njreed53/Power-Factor-Correction-System/images/FunctionalDecomposition.png

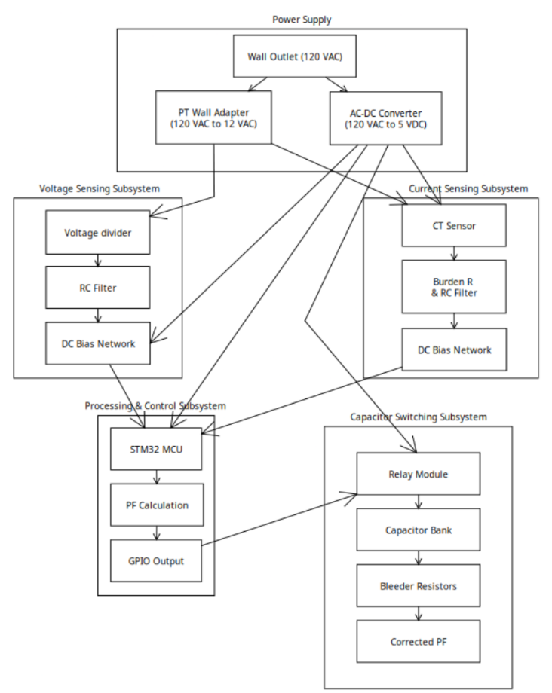
images/FunctionalDecomposition.png
