njreed53/Power-Factor-Correction-System/firmware/Core/Src/main.c

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
/* Includes ------------------------------------------------------------------*/
#include "main.h"

/* USER CODE BEGIN Includes */
#include "I2C_LCD_PCF8574.h"
#include <stdio.h>
#include <stdlib.h>
#include <string.h>
#include <math.h>
/* USER CODE END Includes */

/* USER CODE BEGIN PD */
#define SAMPLE_COUNT 500
#define SENSOR_GAIN     1			// NEED TO ADD GAIN FOR VOLTAGE
#define PF_TARGET       0.95f
#define PF_HYST         0.02f
#define PF_FILTER_SIZE  10
#define Q_MIN           2.0f
#define MIN_V           0.05f
#define MIN_I           0.01f
/* USER CODE END PD */

ADC_HandleTypeDef hadc1;
DMA_HandleTypeDef hdma_adc1;

I2C_HandleTypeDef hi2c1;

TIM_HandleTypeDef htim2;

UART_HandleTypeDef huart2;

/* USER CODE BEGIN PV */
volatile uint32_t adc_dma_buffer[2 * SAMPLE_COUNT];
volatile uint8_t buffer_full = 0;
static uint8_t relay_state = 0;
char msg[50];
char lcd_string[17];
float pf = 0;
float pf_corrected = 0;
float pf_buffer[PF_FILTER_SIZE] = {0};
uint8_t pf_index = 0;
uint8_t pf_filled = 0;
uint8_t freq = 60;
/* USER CODE END PV */

void SystemClock_Config(void);
static void MX_GPIO_Init(void);
static void MX_DMA_Init(void);
static void MX_ADC1_Init(void);
static void MX_TIM2_Init(void);
static void MX_USART2_UART_Init(void);
static void MX_I2C1_Init(void);
/* USER CODE BEGIN PFP */
void UART_PutString(char * uart_str);
void CapBankSwitchLogic(float Qc);
void Relay_On(uint8_t relay);
void Relay_Off(uint8_t relay);
float PF_Filter(float pf_corrected);
/* USER CODE END PFP */

/**
  * @brief  The application entry point.
  * @retval int
  */
int main(void)
{

  /* MCU Configuration--------------------------------------------------------*/

  /* Reset of all peripherals, Initializes the Flash interface and the Systick. */
  HAL_Init();

  /* Configure the system clock */
  SystemClock_Config();

  /* Initialize all configured peripherals */
  MX_GPIO_Init();
  MX_DMA_Init();
  MX_ADC1_Init();
  MX_TIM2_Init();
  MX_USART2_UART_Init();
  MX_I2C1_Init();
  /* USER CODE BEGIN 2 */
  HAL_Delay(5);
  LCD_Start();
  HAL_Delay(5);
  HAL_TIM_Base_Start_IT(&htim2);
  HAL_ADC_Start_DMA(&hadc1, (uint32_t*)adc_dma_buffer, 2*SAMPLE_COUNT);

  HAL_StatusTypeDef ret;

  ret = HAL_I2C_IsDeviceReady(&hi2c1, 0x4E, 3, 100);
  if(ret == HAL_OK)
      UART_PutString("LCD FOUND\r\n");
  else
      UART_PutString("LCD NOT FOUND\r\n");

  /* USER CODE END 2 */

  /* Infinite loop */
  /* USER CODE BEGIN WHILE */
  while (1)
  {
      if(buffer_full)
      {
          buffer_full = 0;
          float v_mean = 0, i_mean = 0;
          float v_rms = 0, i_rms = 0;
          float v, c, v_real, i_real;
          float real_power = 0, apparent_power = 0;
          float volts_per_count = 3.3f / 4095.0f;

          // MEAN CALCULATION (To remove DC offset / center at zero)
          for(int i = 0; i < SAMPLE_COUNT; i++)
          {
              v_mean += adc_dma_buffer[2*i];
              i_mean += adc_dma_buffer[2*i + 1];
          }
          v_mean /= SAMPLE_COUNT;
          i_mean /= SAMPLE_COUNT;

          // RMS + REAL POWER + APPARENT POWER
          for(int i = 0; i < SAMPLE_COUNT; i++)
          {
              v = adc_dma_buffer[2*i] - v_mean;
              c = adc_dma_buffer[2*i + 1] - i_mean;

              v_real = v * volts_per_count;
              i_real = (c * volts_per_count) / SENSOR_GAIN;		// PRIORITY // CT: Is = (Ip / 1000) // Vs = Is * (50 0hm) // Pot gain is 20, 50/1000 = .05*20 = 1
              	  	  	  	  	  	  	  	  	  	  	  	  	// SENSOR GAIN SHOULD BE 1
              v_rms += (v_real * v_real);
              i_rms += (i_real * i_real);

              real_power += (v_real * i_real);
          }
          v_rms = sqrtf(v_rms / SAMPLE_COUNT);
          i_rms = sqrtf(i_rms / SAMPLE_COUNT);

          // --------------------------------------------------------------------------------
          static uint32_t last_switch_time = 0;

    	  // Emergency_Shutoff
          int Emergency;
          if (HAL_GPIO_ReadPin(Emergency_Shutoff_GPIO_Port, Emergency_Shutoff_Pin) == GPIO_PIN_SET)
          {Emergency = 1;}

          // Over/Under Voltage Protection (Relay 8)
          if (v_rms < 108.0f || v_rms > 132.0f || Emergency)
          {
              Relay_Off(8); // Shut off main
              CapBankSwitchLogic(0);
              last_switch_time = HAL_GetTick();
              UART_PutString("VOLTAGE FAULT \r\n");
          }
          else if (HAL_GetTick() - last_switch_time > 3000)
          {Relay_On(8);}

          // Load 1 / Load 2
          if (HAL_GPIO_ReadPin(Load1_GPIO_Port, Load1_Pin) == GPIO_PIN_SET)
          {Relay_On(6);}
          else if (HAL_GetTick() - last_switch_time > 3000)
          {Relay_Off(6);}
          if (HAL_GPIO_ReadPin(Load2_GPIO_Port, Load2_Pin) == GPIO_PIN_SET)
          {Relay_On(7);}
          else if (HAL_GetTick() - last_switch_time > 3000)
          {Relay_Off(7);}
          // ----------------------------------------------------------------------------------

          real_power /= SAMPLE_COUNT;
          apparent_power = (v_rms * i_rms);

          // SIGNAL VALIDATION + POWER FACTOR
          if(v_rms < MIN_V || i_rms < MIN_I)
          {
              Relay_Off(1);
              Relay_Off(2);
              Relay_Off(3);
              Relay_Off(4);
              Relay_Off(5);

              relay_state = 0;

              UART_PutString("Signal too small \r\n");
              HAL_ADC_Start_DMA(&hadc1, (uint32_t*)adc_dma_buffer, 2*SAMPLE_COUNT);
              //continue; // Returns to top of loop											UNCOMMENT UNCOMMENT UNCOMMENT UNCOMMENT
          }
          else
          {
              pf = real_power / apparent_power;
              float angle = acosf(pf);					// in radians
              pf_corrected = cosf(angle + 0.349); // 20 degrees*(pi/180) = 0.349 radians // 20 degree offset from CT	// Check again after voltage module
          }

          // Clamp
          if(pf_corrected >= 1) pf_corrected = 0.999f;	 // Prevent acos/tan instability
          if(pf_corrected <= -1) pf_corrected = -0.999f; // Prevent acos/tan instability

          // Filter
          float pf_safe = PF_Filter(pf_corrected);

          // REACTIVE POWER
          float Qcurrent = real_power * tanf(acosf(pf_safe));
          float Qtarget  = real_power * tanf(acosf(PF_TARGET));
          float Qc = Qcurrent - Qtarget;
          float C = (Qc / (2.0f * M_PI * freq * (v_rms * v_rms))) * 1000000.0f;

          // DEAD BAND
          if(pf_safe > (PF_TARGET - PF_HYST) && pf_safe < (PF_TARGET + PF_HYST))
          {
              snprintf(msg, 50, "PF: %.2f (stable) \r\n", pf_safe);
              UART_PutString(msg);
              HAL_ADC_Start_DMA(&hadc1, (uint32_t*)adc_dma_buffer, 2*SAMPLE_COUNT);
              //continue;																UNCOMMENT UNCOMMENT UNCOMMENT UNCOMMENT
          }

          // RELAY DELAY
          if(HAL_GetTick() - last_switch_time < 3000)
        	  HAL_ADC_Start_DMA(&hadc1, (uint32_t*)adc_dma_buffer, 2*SAMPLE_COUNT);
              //continue;																UNCOMMENT UNCOMMENT UNCOMMENT UNCOMMENT

          // CONTROL LOGIC
          if(pf_safe < (PF_TARGET - PF_HYST))
          {
              // Need more capacitance
              CapBankSwitchLogic(C);
              last_switch_time = HAL_GetTick();
          }
          else if(pf_safe > (PF_TARGET + PF_HYST))
          {
        	  CapBankSwitchLogic(0);
        	  last_switch_time = HAL_GetTick();
          }

          // Print values to terminal
          snprintf(msg, 50, "V: %.2f V, I: %.2f A, PF: %.3f \r\n", v_rms, i_rms, pf_safe);
          UART_PutString(msg);


          // LCD_PutChar(sel+0x30); or just the number you want: 0x3#
          // Print values to LCD
          LCD_ClearDisplay();
          snprintf(lcd_string, 17, "PF: %.2f", pf_safe);
          //LCD_Position(0, 0);
          LCD_PrintString(lcd_string);
          snprintf(lcd_string, 17, "V:%.1f I:%.1f", v_rms, i_rms);
          LCD_Position(1, 0);
          LCD_PrintString(lcd_string);

          HAL_ADC_Start_DMA(&hadc1, (uint32_t*)adc_dma_buffer, 2*SAMPLE_COUNT);
      }

    /* USER CODE END WHILE */

    /* USER CODE BEGIN 3 */
  }
  /* USER CODE END 3 */
}

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
/* USER CODE BEGIN 4 */

void UART_PutString(char * uart_str)
{
	HAL_UART_Transmit(&huart2, (uint8_t *)uart_str, strnlen(uart_str, 80), -1);
}

void HAL_ADC_ConvCpltCallback(ADC_HandleTypeDef* hadc)
{
    if(hadc->Instance == ADC1)
    {
    	HAL_ADC_Stop_DMA(&hadc1);
        buffer_full = 1;
    }
}

void Relay_On(uint8_t relay)
{
    switch(relay)
    {
        case 1:
            HAL_GPIO_WritePin(GPIOA, Relay1_Pin, GPIO_PIN_SET);
            snprintf(msg, 50, "Relay 1 ON \r\n");
            break;

        case 2:
            HAL_GPIO_WritePin(GPIOA, Relay2_Pin, GPIO_PIN_SET);
            snprintf(msg, 50, "Relay 2 ON \r\n");
            break;

        case 3:
            HAL_GPIO_WritePin(GPIOA, Relay3_Pin, GPIO_PIN_SET);
            snprintf(msg, 50, "Relay 3 ON \r\n");
            break;

        case 4:
            HAL_GPIO_WritePin(GPIOA, Relay4_Pin, GPIO_PIN_SET);
            snprintf(msg, 50, "Relay 4 ON \r\n");
            break;

        case 5:
            HAL_GPIO_WritePin(GPIOB, Relay5_Pin, GPIO_PIN_SET);
            snprintf(msg, 50, "Relay 5 ON \r\n");
            break;

        case 6:
            HAL_GPIO_WritePin(GPIOB, Relay6_Pin, GPIO_PIN_SET);
            snprintf(msg, 50, "Relay 6 ON \r\n");
            break;
        case 7:
            HAL_GPIO_WritePin(GPIOA, Relay7_Pin, GPIO_PIN_SET);
            snprintf(msg, 50, "Relay 7 ON \r\n");
            break;
        case 8:
            HAL_GPIO_WritePin(GPIOA, Relay8_Pin, GPIO_PIN_SET);
            snprintf(msg, 50, "Relay 8 ON \r\n");
            break;
    }
    UART_PutString(msg);
}

void Relay_Off(uint8_t relay)
{
    switch(relay)
    {
        case 1:
            HAL_GPIO_WritePin(GPIOA, Relay1_Pin, GPIO_PIN_RESET);
            snprintf(msg, 50, "Relay 1 OFF \r\n");
            break;

        case 2:
            HAL_GPIO_WritePin(GPIOA, Relay2_Pin, GPIO_PIN_RESET);
            snprintf(msg, 50, "Relay 2 OFF \r\n");
            break;

        case 3:
            HAL_GPIO_WritePin(GPIOA, Relay3_Pin, GPIO_PIN_RESET);
            snprintf(msg, 50, "Relay 3 OFF \r\n");
            break;

        case 4:
            HAL_GPIO_WritePin(GPIOA, Relay4_Pin, GPIO_PIN_RESET);
            snprintf(msg, 50, "Relay 4 OFF \r\n");
            break;

        case 5:
            HAL_GPIO_WritePin(GPIOB, Relay5_Pin, GPIO_PIN_RESET);
            snprintf(msg, 50, "Relay 5 OFF \r\n");
            break;

        case 6:
            HAL_GPIO_WritePin(GPIOB, Relay6_Pin, GPIO_PIN_RESET);
            snprintf(msg, 50, "Relay 6 OFF \r\n");
            break;
        case 7:
            HAL_GPIO_WritePin(GPIOA, Relay7_Pin, GPIO_PIN_RESET);
            snprintf(msg, 50, "Relay 7 OFF \r\n");
            break;
        case 8:
            HAL_GPIO_WritePin(GPIOA, Relay8_Pin, GPIO_PIN_RESET);
            snprintf(msg, 50, "Relay 8 OFF \r\n");
            break;
    }
    UART_PutString(msg);
}

void CapBankSwitchLogic(float C)
{
    uint8_t new_state = 0;
    		// Relay: 1		2	  3		4	   5
    float caps[5] = {1.0f, 2.0f, 5.0f, 10.0f, 20.0f};

    // Start from largest to smallest
    for(int i = 4; i >= 0; i--)
    {
        if(C >= caps[i])
        {
            new_state |= (1 << i);	// MSB is relay (5) with largest reactive power
            C -= caps[i];
        }
    }

    // Apply only changes
    for(int i = 0; i < 5; i++)
    {
        uint8_t mask = (1 << i);

        if((new_state & mask) && !(relay_state & mask))
            Relay_On(i+1);

        else if(!(new_state & mask) && (relay_state & mask))
            Relay_Off(i+1);
    }

    relay_state = new_state;

    snprintf(msg, 50, "C: %.1f State: %d \r\n", C, relay_state);					//STATE NEEDS CHANGED FROM 8 BITS (DISPAYING AS DECIMAL EX. 31) TO ACTUAL BINARY
    UART_PutString(msg);
}

float PF_Filter(float pf_corrected)
{
    pf_buffer[pf_index++] = pf_corrected;

    if(pf_index >= PF_FILTER_SIZE)
    {
        pf_index = 0;
        pf_filled = 1;
    }

    float sum = 0;
    float count = pf_filled ? PF_FILTER_SIZE : pf_index;

    if (count == 0) return pf_corrected;

    for(int i = 0; i < count; i++)
        sum += pf_buffer[i];

    return sum / count;
}
/* USER CODE END 4 */
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
