njreed53/Power-Factor-Correction-System/firmware/Core/Inc/main.h

#define MCO_Pin GPIO_PIN_0
#define MCO_GPIO_Port GPIOF
#define Voltage_Pin GPIO_PIN_0
#define Voltage_GPIO_Port GPIOA
#define Current_Pin GPIO_PIN_1
#define Current_GPIO_Port GPIOA
#define Relay1_Pin GPIO_PIN_4
#define Relay1_GPIO_Port GPIOA
#define Relay2_Pin GPIO_PIN_5
#define Relay2_GPIO_Port GPIOA
#define Relay3_Pin GPIO_PIN_6
#define Relay3_GPIO_Port GPIOA
#define Relay4_Pin GPIO_PIN_7
#define Relay4_GPIO_Port GPIOA
#define Relay5_Pin GPIO_PIN_0
#define Relay5_GPIO_Port GPIOB
#define Relay6_Pin GPIO_PIN_1
#define Relay6_GPIO_Port GPIOB
#define LED_Pin GPIO_PIN_9
#define LED_GPIO_Port GPIOA
#define Relay7_Pin GPIO_PIN_11
#define Relay7_GPIO_Port GPIOA
#define Relay8_Pin GPIO_PIN_12
#define Relay8_GPIO_Port GPIOA
#define SWDIO_Pin GPIO_PIN_13
#define SWDIO_GPIO_Port GPIOA
#define SWCLK_Pin GPIO_PIN_14
#define SWCLK_GPIO_Port GPIOA
#define Load2_Pin GPIO_PIN_3
#define Load2_GPIO_Port GPIOB
#define Load1_Pin GPIO_PIN_4
#define Load1_GPIO_Port GPIOB
#define Emergency_Shutoff_Pin GPIO_PIN_5
#define Emergency_Shutoff_GPIO_Port GPIOB
